zcking/caffeinate-switch/(commit log)

2026-09-08 docs: design caffeinate switch
2026-09-09 docs: plan caffeinate switch implementation
2026-09-09 feat: add ESP32 switch firmware
2026-09-09 fix: reconcile switch state on USB reconnect
    [SwitchController.cpp, SwitchController.h, main.cpp]
2026-09-09 feat: reconcile switch and caffeinate state
2026-09-09 fix: stage app bundle replacements
2026-09-09 feat: add printable cafe enclosure
    [caffeinate_switch.scad]
2026-09-09 fix: strengthen printable enclosure geometry
    [caffeinate_switch.scad]
2026-09-09 fix: enforce radial CAD roof slopes
    [caffeinate_switch.scad]
2026-09-09 docs: add complete build and assembly guide
2026-09-09 fix: resolve final review blockers
    [caffeinate_switch.scad]
2026-09-09 fix: use Arduino USB CDC event constants
    [main.cpp]
2026-09-09 fix: tolerate light window precision
    [caffeinate_switch.scad]
2026-09-10 fix: loosen ESP32 retaining rails
    [caffeinate_switch.scad]
2026-09-12 feat: support classic ESP32 DevKit alongside ESP32-S3
    Add an esp32dev PlatformIO env with UART-bridge session handling, broaden Mac serial discovery beyond usbmodem, and document dual-board flash and wiring.
